mattpidden/bus-stop-display/cad/front.step

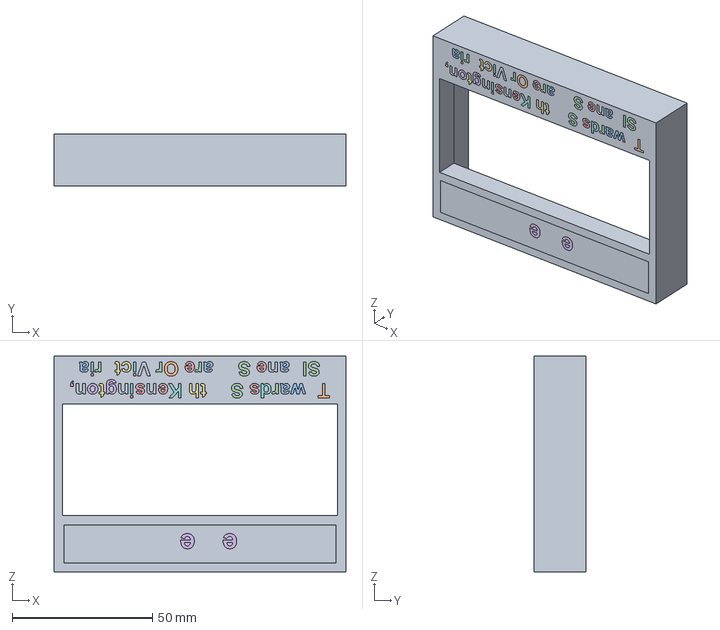
[picture p6: CAD file, 2026-10-06]
cad/front.step
104.0 x 18.5 x 76.8 mm
