mattpidden/bus-stop-display/cad/back.step

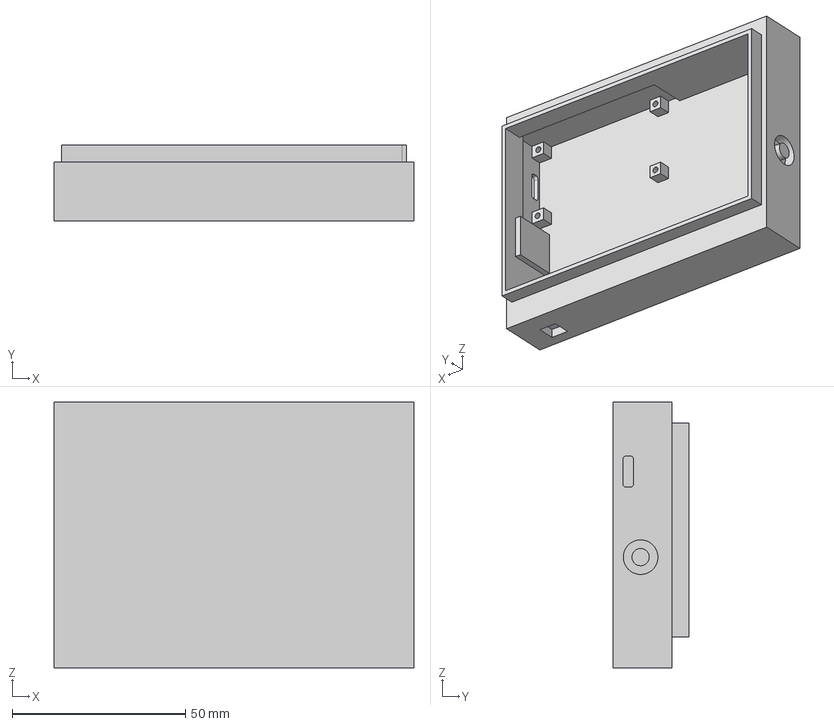
[picture p7: CAD file, 2026-10-06]
cad/back.step
104.0 x 22.0 x 76.8 mm
