mattpidden/bus-stop-display/cad/stand.step

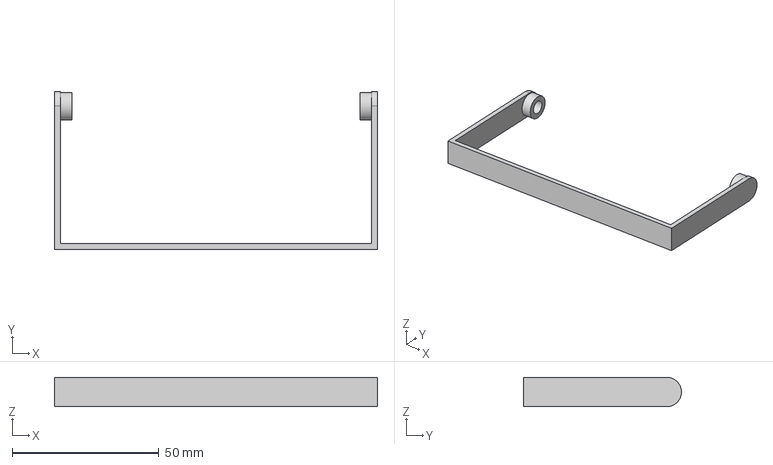
[picture p8: CAD file, 2026-10-06]
cad/stand.step
110.0 x 53.8 x 10.0 mm
