mattpidden/bus-stop-display/firmware/BusStopScreen/secrets.example.h

// Copy this file to secrets.h and fill in your Wi-Fi details.
// secrets.h is listed in .gitignore so your credentials are never committed.
#pragma once

#define WIFI_SSID     "your-wifi-name"
#define WIFI_PASSWORD "your-wifi-password"
